samuk/M5Stack_Servo_Driver/Case/SERVO_8.3mm_0.7mm.step

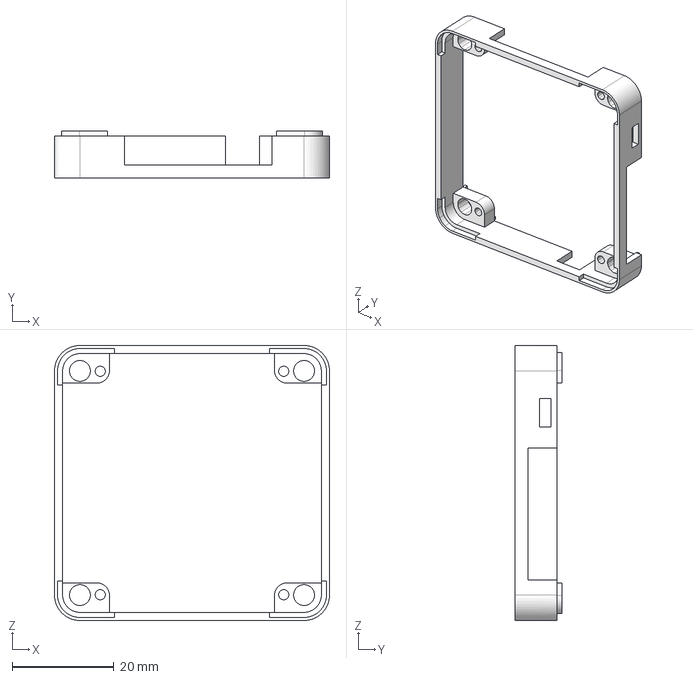
[picture p3: CAD file, 2019-04-29]
Case/SERVO_8.3mm_0.7mm.step
54.0 x 9.30 x 54.0 mm
