samuk/M5Stack_Servo_Driver/(list of files, cad)

Other CAD files:
Case/SERVO_8.3mm_0.7mm.f3d
Case/SERVO_8.3mm_0.7mm.stl
