samuk/M5Stack_Servo_Driver/M5_PCA9685_v02_schematics.pdf

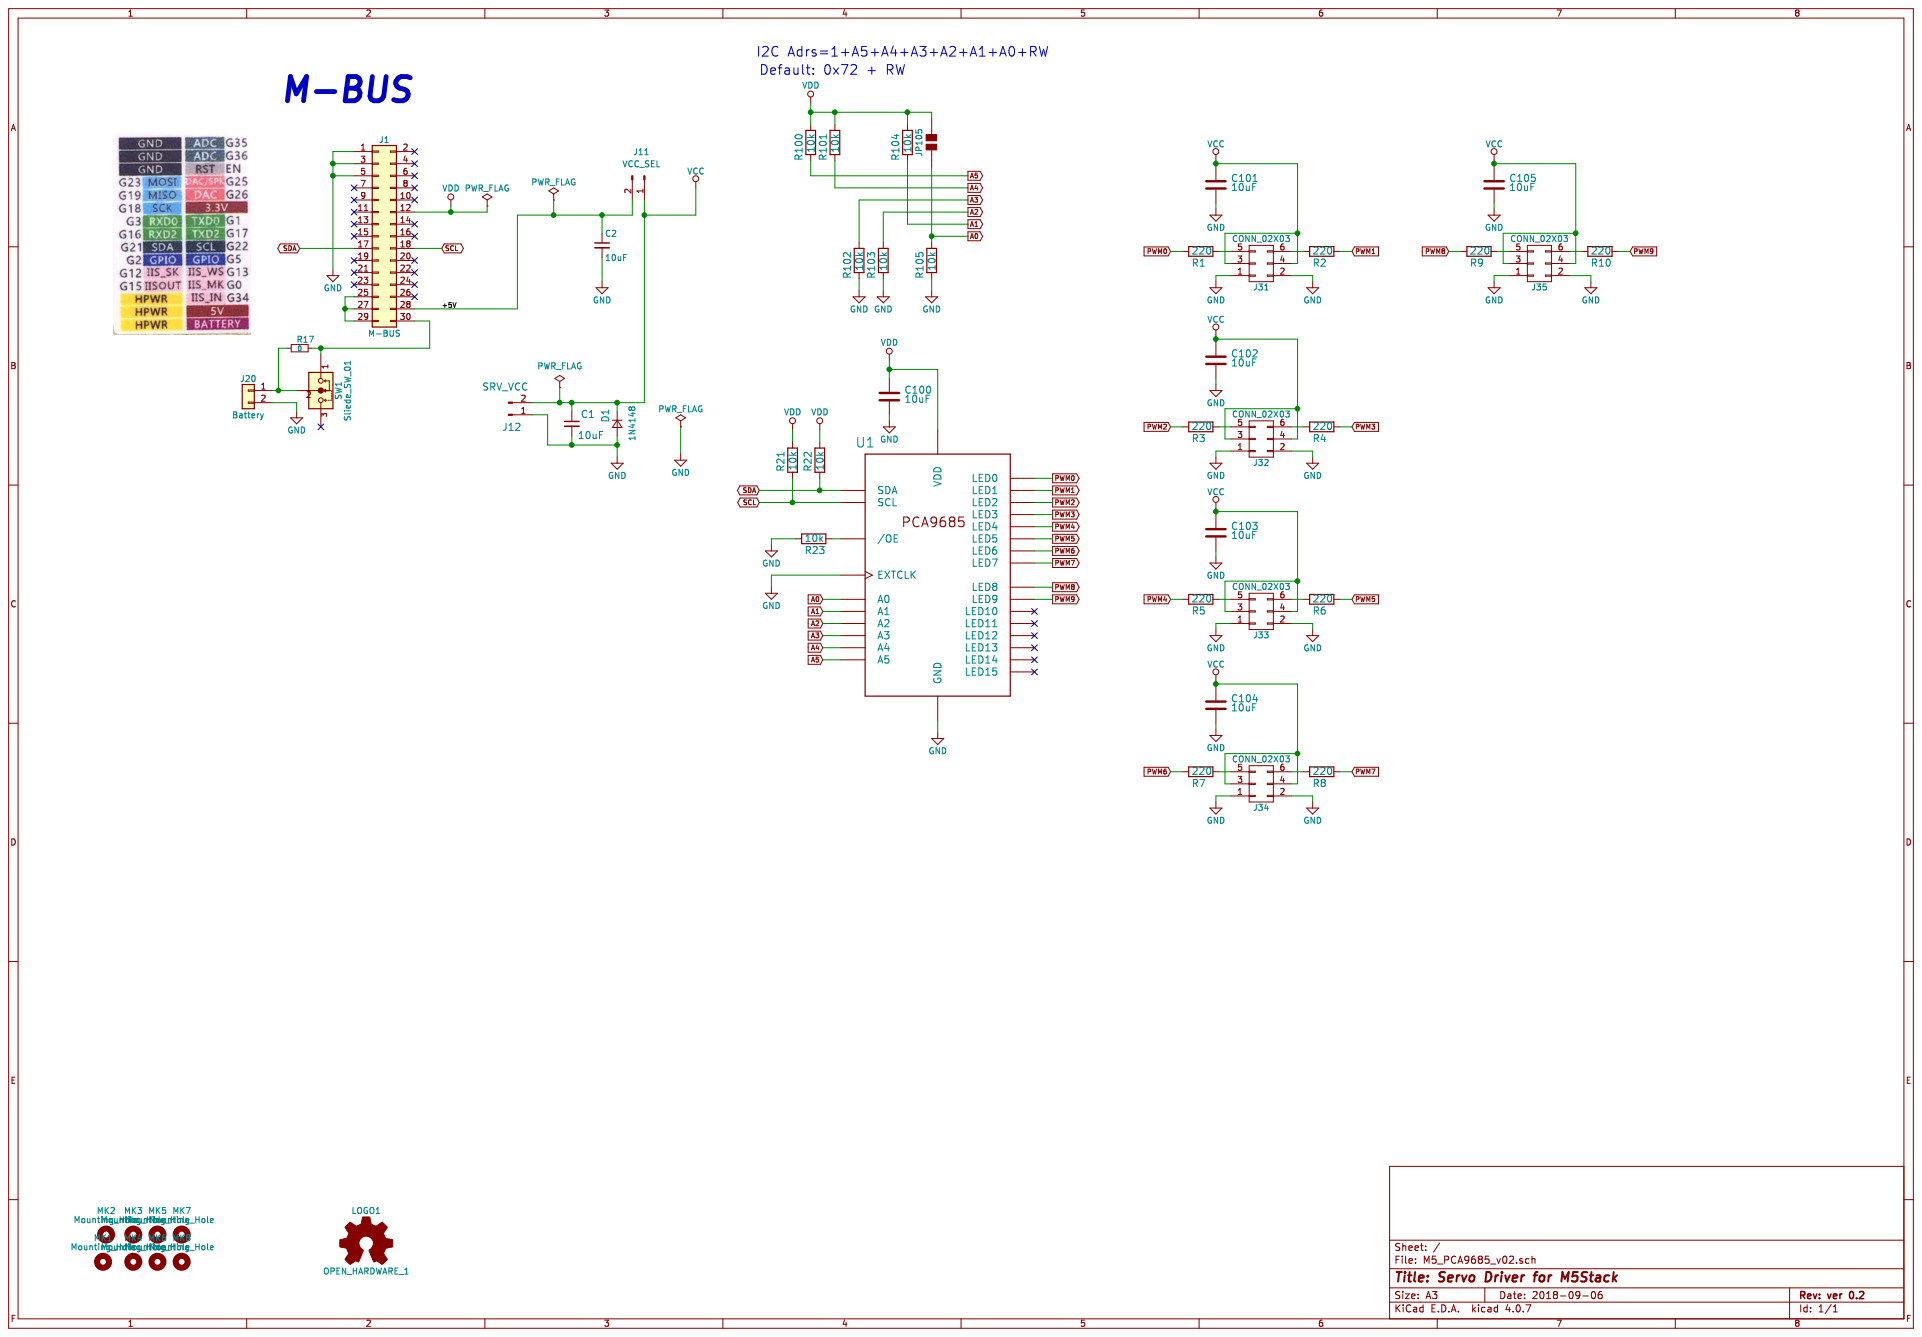
[picture p4: page 1]
