samuk/M5Stack_Servo_Driver/KiCad/M5_PCA9685_v02/M5_PCA9685_v02.kicad_pcb

## KiCad design KiCad/M5_PCA9685_v02/M5_PCA9685_v02.kicad_pcb (2019-02-03)

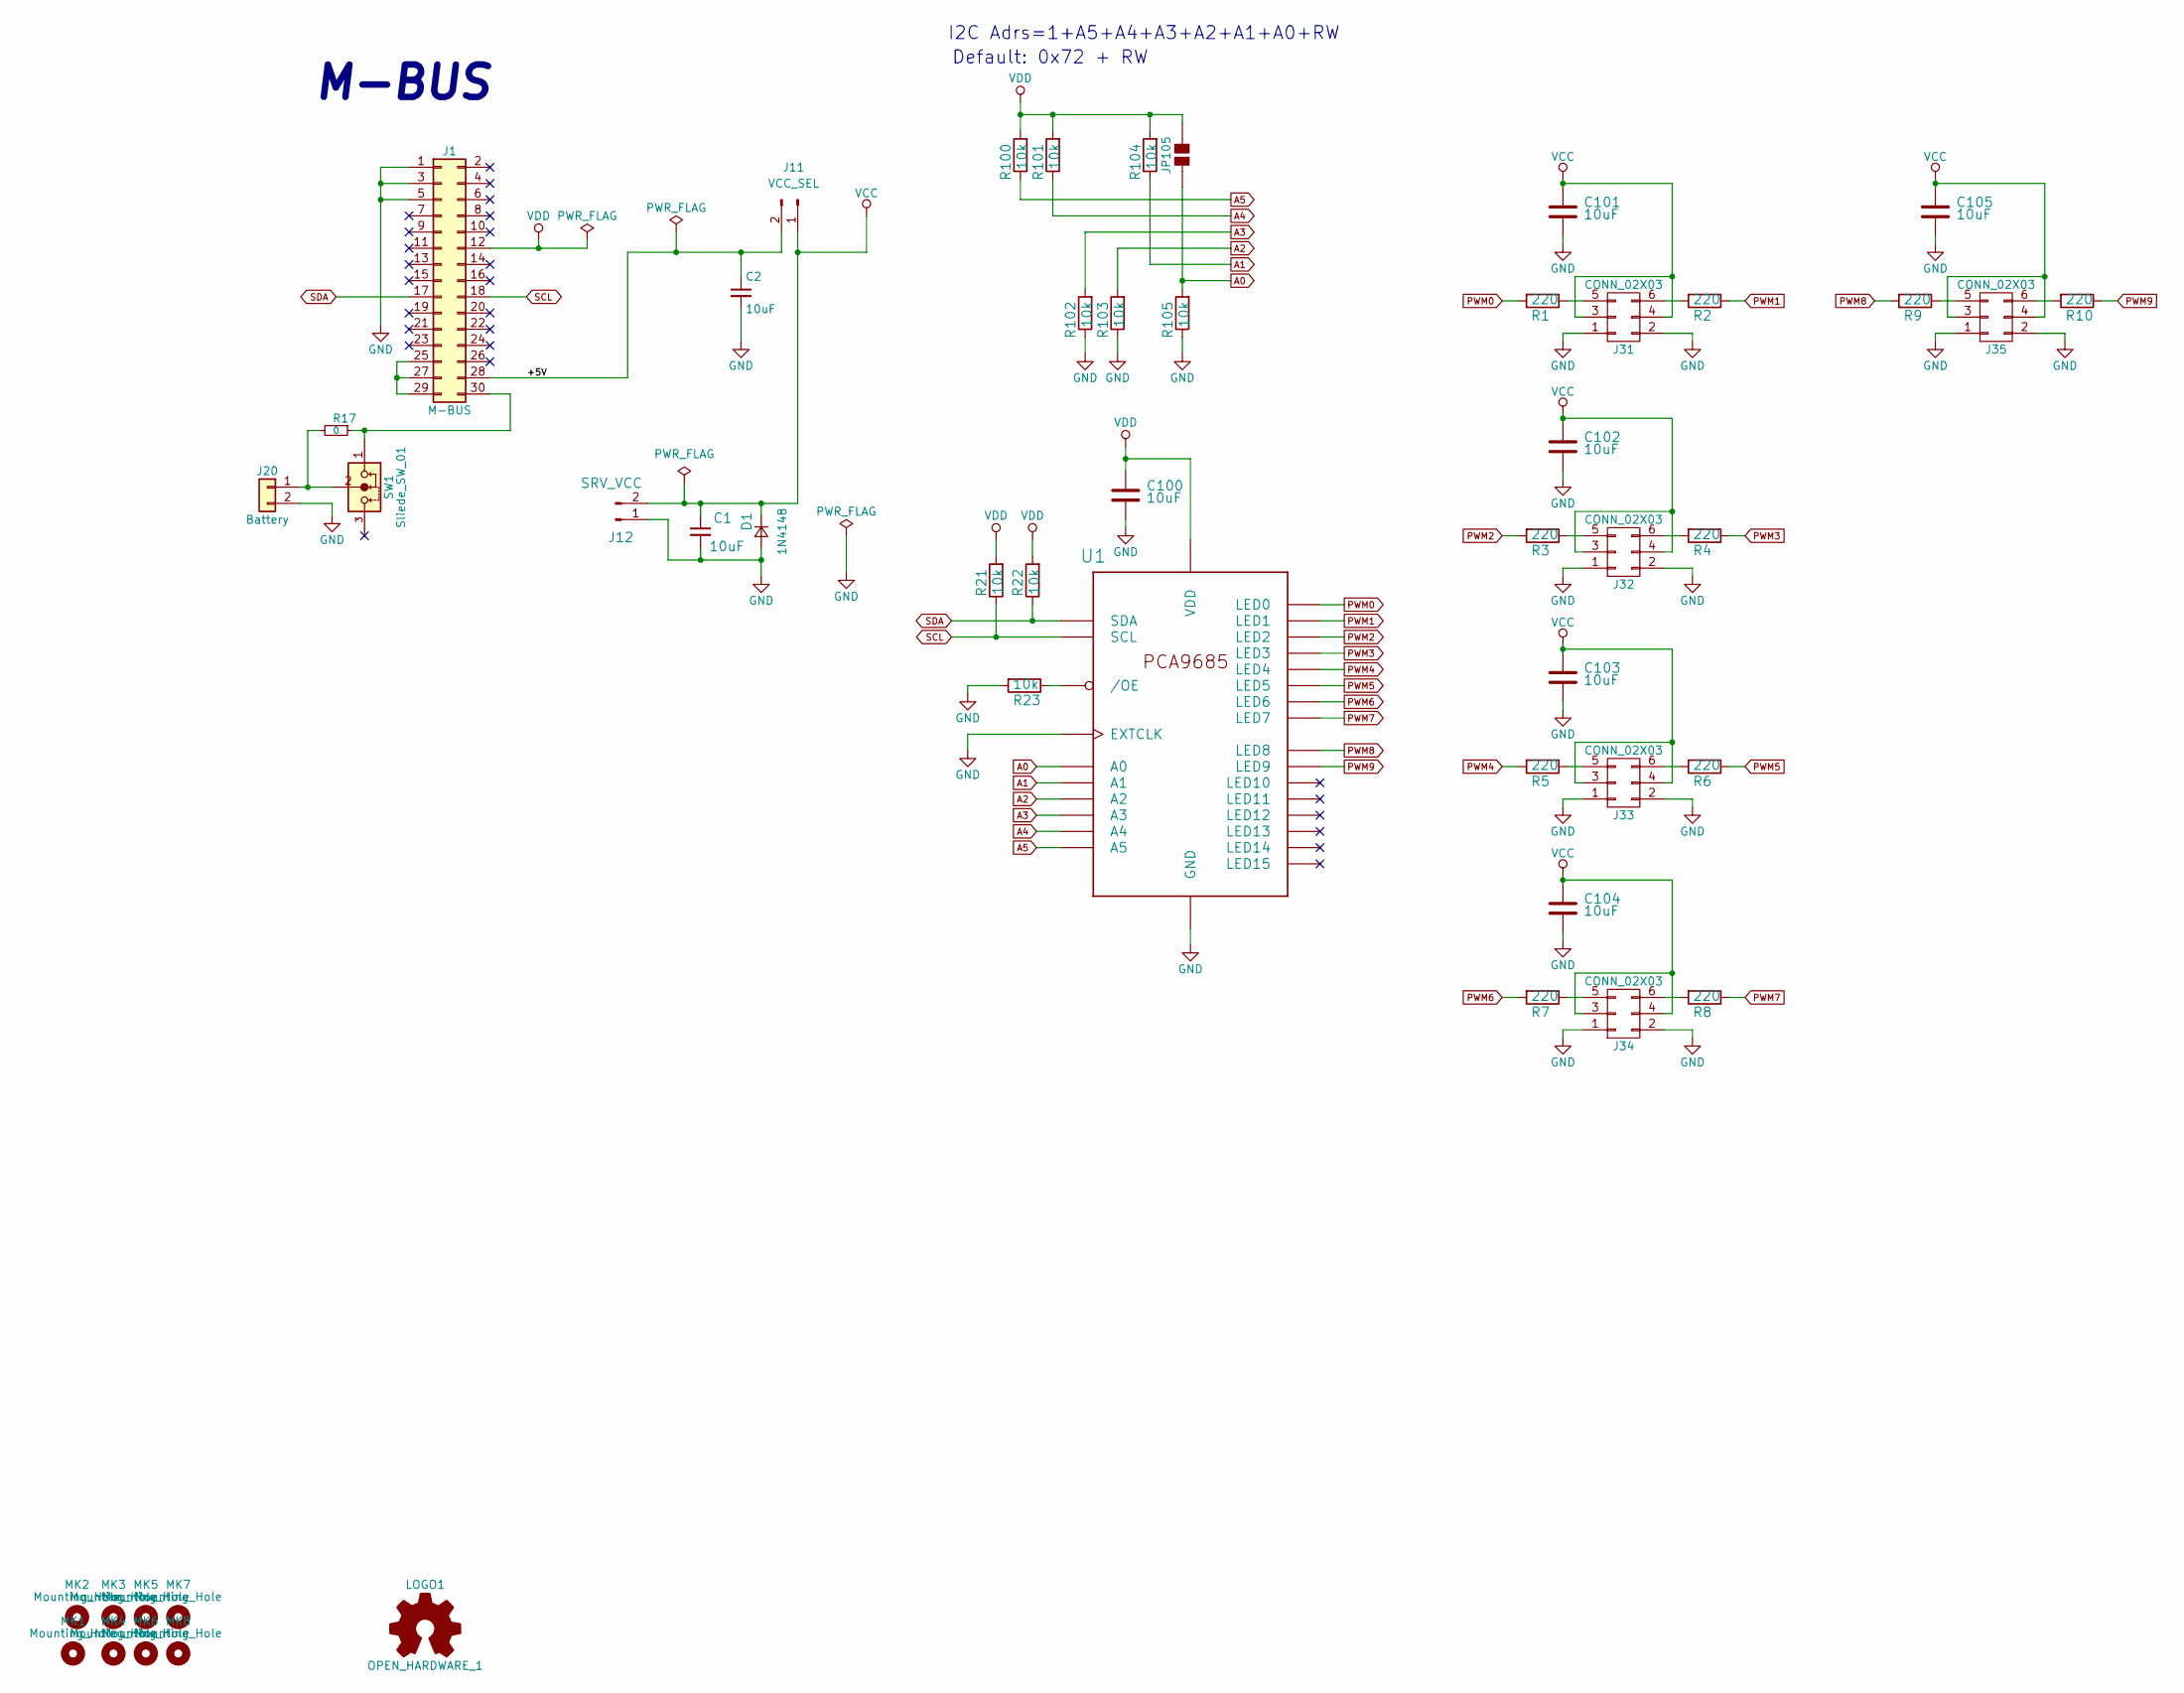
[picture p5: schematic M5_PCA9685_v02.sch, Servo Driver for M5Stack]

Parts:
C1, C2, C100, C101, C102, C103, C104, C105: 10uF; C_0603
D1: 1N4148; D_SOD-323
J1: M-BUS; Pin_Header_MBUS_SMD_TH
J11: VCC_SEL; Pin_Header_Angled_1x02_Pitch2.54mm
J12: SRV_VCC; Pin_Header_Angled_1x02_Pitch2.54mm
J20: Battery; Pin_Header_Angled_1x02_Pitch2.54mm
J31, J32, J33, J34, J35: CONN_02X03; Pin_Header_Angled_2x03_Pitch2.54mm
JP105: SOLDERJUMPER; SOLDERJUMPER_REFLOW
LOGO1: OPEN_HARDWARE_1; OSHW-logo_silkscreen-front_3mm
MK1, MK2, MK3, MK4: Mounting_Hole; MountingHole_3.2mm_M3
MK5, MK6, MK7, MK8: Mounting_Hole; MountingHole_2.2mm_M2
R1, R2, R3, R4, R5, R6, R7, R8, R9, R10: 220; R_0603
R17: 0; R_0603
R21, R22, R23, R100, R101, R102, R103, R104, R105: 10k; R_0603
SW1: Sliede_SW_01; slide_switch_angled
U1: PCA9685; PCA9685_TSSOP28

Connections:
/+5V: C2.1, J1.28, J11.2
A0: JP105.2, R105.2, U1.1 (A0)
A1: R104.1, U1.2 (A1)
A2: R103.2, U1.3 (A2)
A3: R102.2, U1.4 (A3)
A4: R101.1, U1.5 (A4)
A5: R100.1, U1.24 (A5)
GND: C1.2, C2.2, C100.2, C101.2, C102.2, C103.2, C104.2, C105.2, D1.2 (A), J1.1, J1.3, J1.5, J12.1, J20.2, J31.1, J31.2, J32.1, J32.2, J33.1, J33.2, J34.1, J34.2, J35.1, J35.2, R23.2, R102.1, R103.1, R105.1, U1.14 (GND), U1.25 (EXTCLK)
unnamed: J1.25, J1.27, J1.29
unnamed: J1.30, R17.1, SW1.1
unnamed: J20.1, R17.2, SW1.2
unnamed: J31.5, R1.1
unnamed: J31.6, R2.2
unnamed: J32.5, R3.1
unnamed: J32.6, R4.2
unnamed: J33.5, R5.1
unnamed: J33.6, R6.2
unnamed: J34.5, R7.1
unnamed: J34.6, R8.2
unnamed: J35.5, R9.1
unnamed: J35.6, R10.2
unnamed: R23.1, U1.23 (/OE)
PWM0: R1.2, U1.6 (LED0)
PWM1: R2.1, U1.7 (LED1)
PWM2: R3.2, U1.8 (LED2)
PWM3: R4.1, U1.9 (LED3)
PWM4: R5.2, U1.10 (LED4)
PWM5: R6.1, U1.11 (LED5)
PWM6: R7.2, U1.12 (LED6)
PWM7: R8.1, U1.13 (LED7)
PWM8: R9.2, U1.15 (LED8)
PWM9: R10.1, U1.16 (LED9)
SCL: J1.18, R21.1, U1.26 (SCL)
SDA: J1.17, R22.1, U1.27 (SDA)
VCC: C1.1, C101.1, C102.1, C103.1, C104.1, C105.1, D1.1 (K), J11.1, J12.2, J31.3, J31.4, J32.3, J32.4, J33.3, J33.4, J34.3, J34.4, J35.3, J35.4
VDD: C100.1, J1.12, JP105.1, R21.2, R22.2, R100.2, R101.2, R104.2, U1.28 (VDD)

Notes on the sheet:
I2C Adrs=1+A5+A4+A3+A2+A1+A0+RW
M-BUS
Default: 0x72 + RW

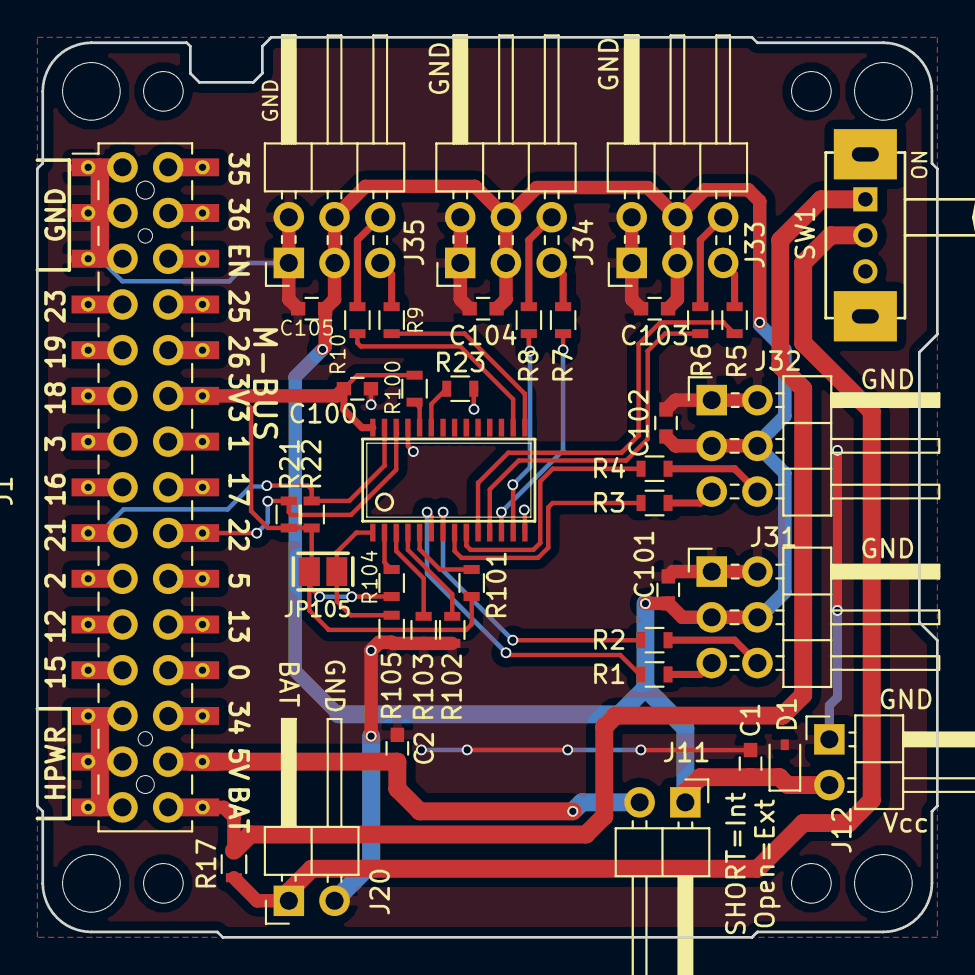
[picture p6: board M5_PCA9685_v02.kicad_pcb from above]

Board: 2 copper layers, 50.0 x 50.0 mm, 50 parts (1 on the bottom side), 36 nets.
